SConsul/SoundLocalizer/Simulation/Comparator.PNG

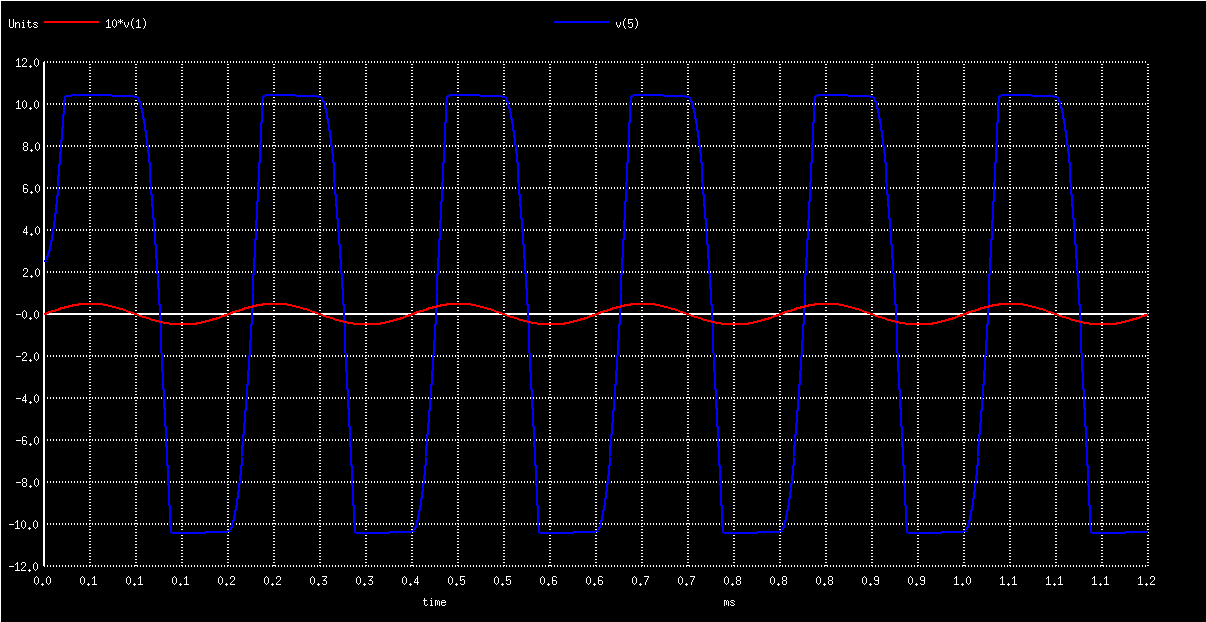
Simulation/Comparator.PNG
