SConsul/SoundLocalizer/Simulation/DelayCir/VT=0.PNG

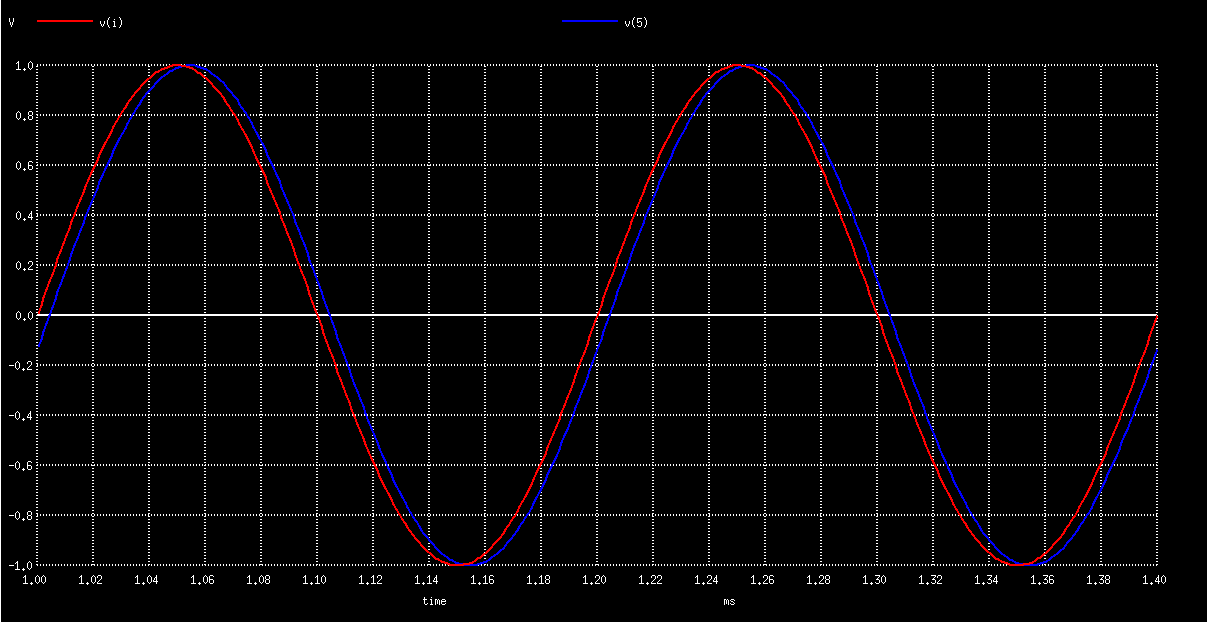
Simulation/DelayCir/VT=0.PNG
