SConsul/SoundLocalizer/Simulation/DelayCir/VT=-3.PNG

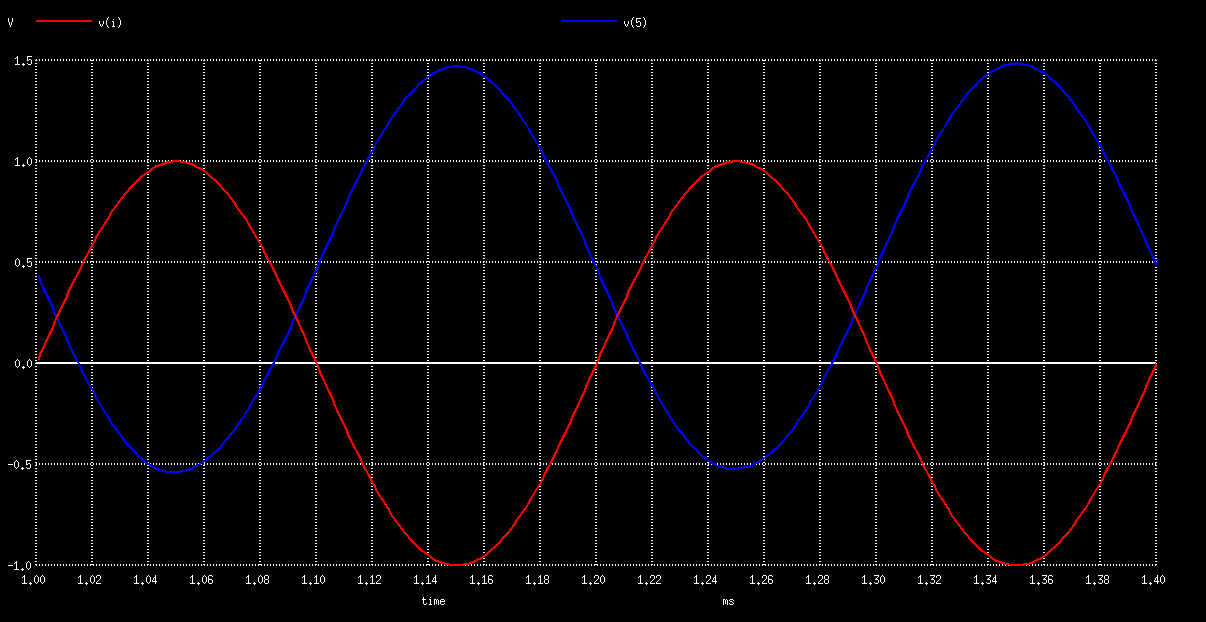
Simulation/DelayCir/VT=-3.PNG
