SConsul/SoundLocalizer/Simulation/DelayCircuit/0.4V.PNG

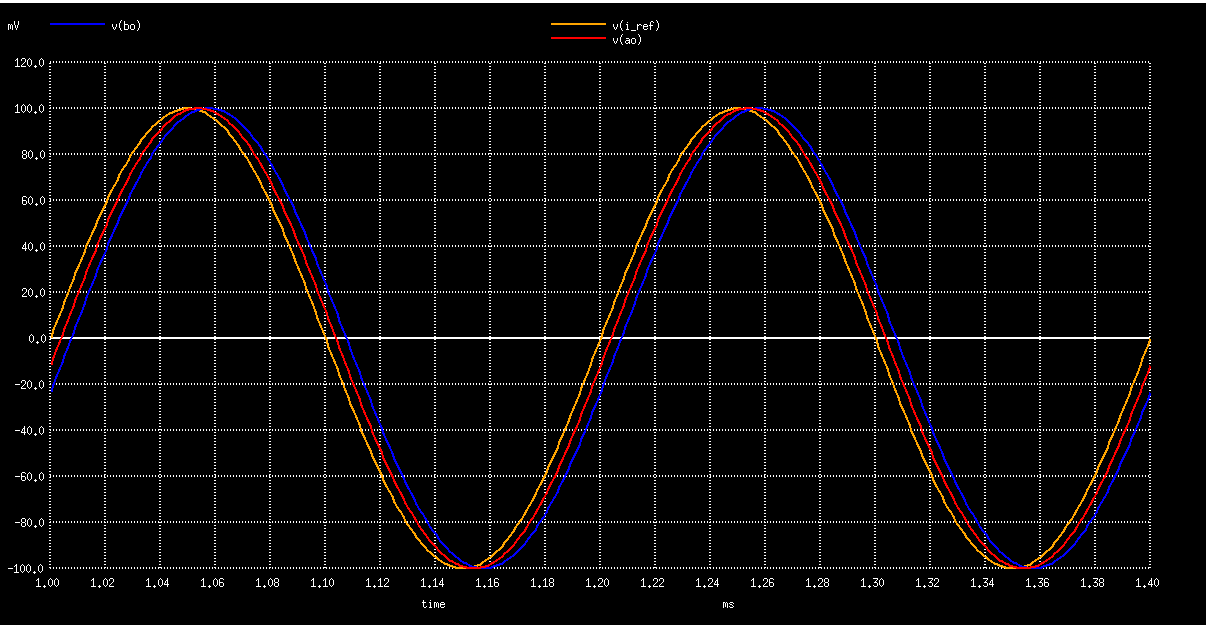
Simulation/DelayCircuit/0.4V.PNG
