SConsul/SoundLocalizer/Simulation/DelayCircuit/-0.8V.PNG

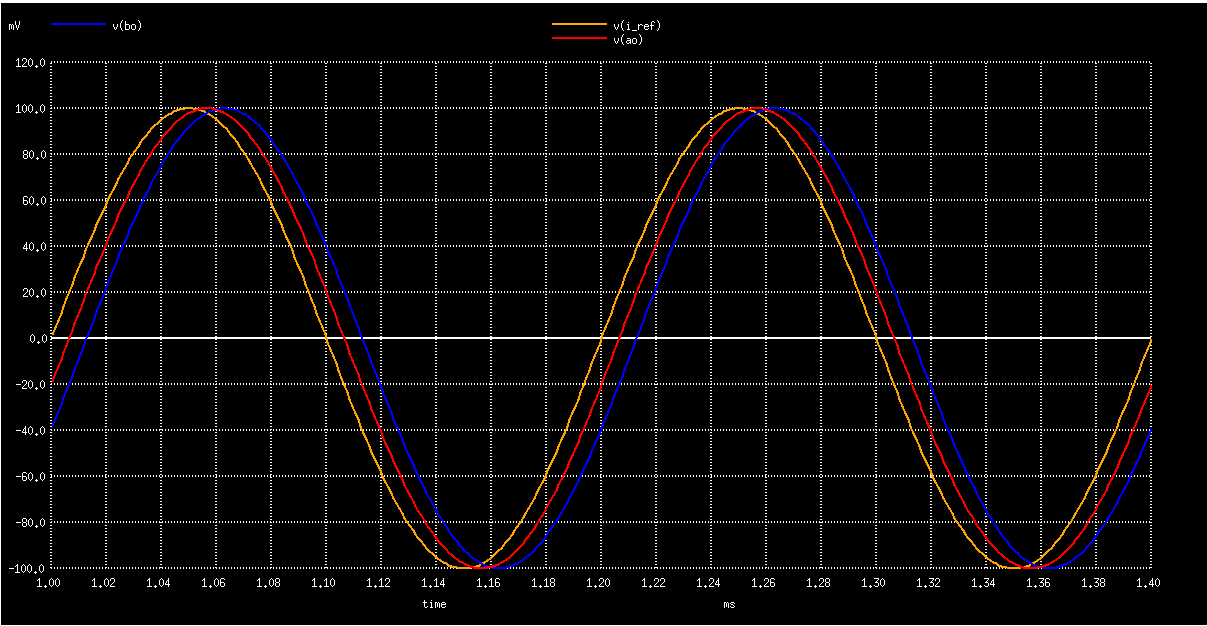
Simulation/DelayCircuit/-0.8V.PNG
