SConsul/SoundLocalizer/Simulation/DelayCircuit/-1.6V.PNG

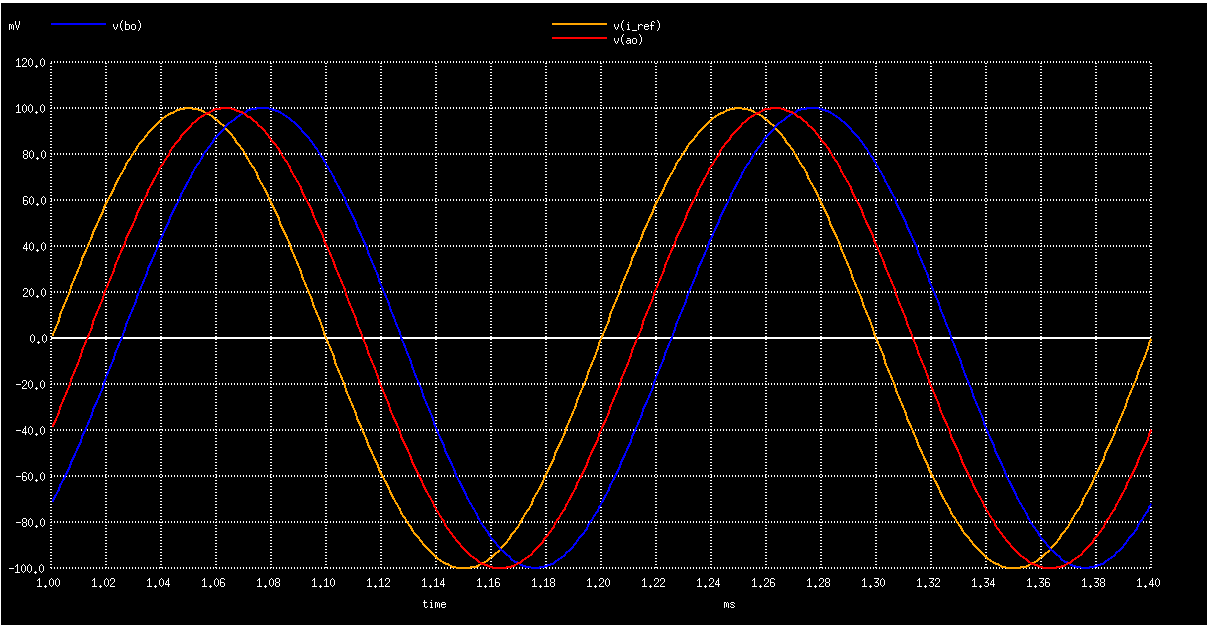
Simulation/DelayCircuit/-1.6V.PNG
