SConsul/SoundLocalizer/Simulation/Integrator/int_Square.PNG

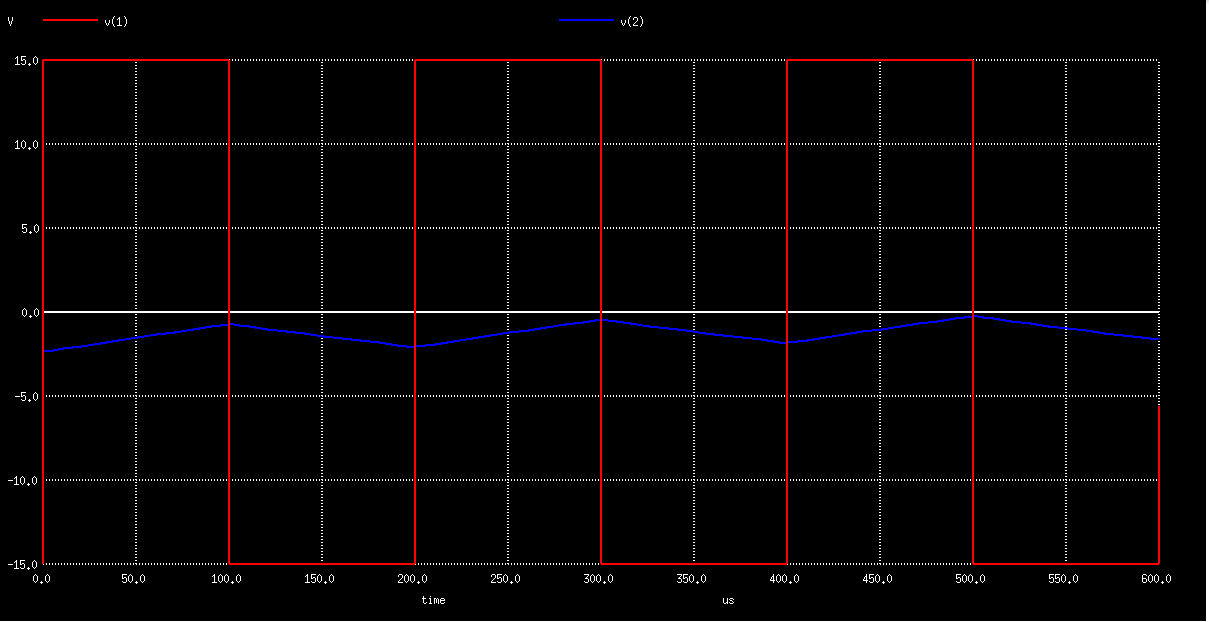
Simulation/Integrator/int_Square.PNG
