SConsul/SoundLocalizer/Simulation/JFET_IV/Id_vs_Vgs.PNG

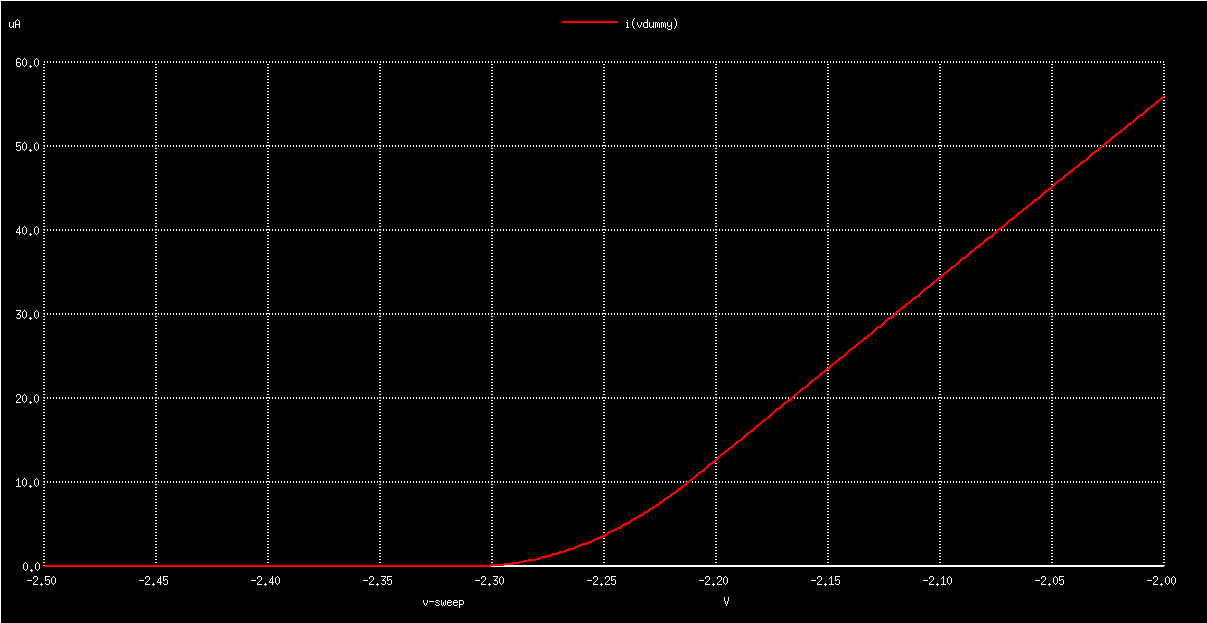
Simulation/JFET_IV/Id_vs_Vgs.PNG
