SConsul/SoundLocalizer/Simulation/JFET_IV/IV.PNG

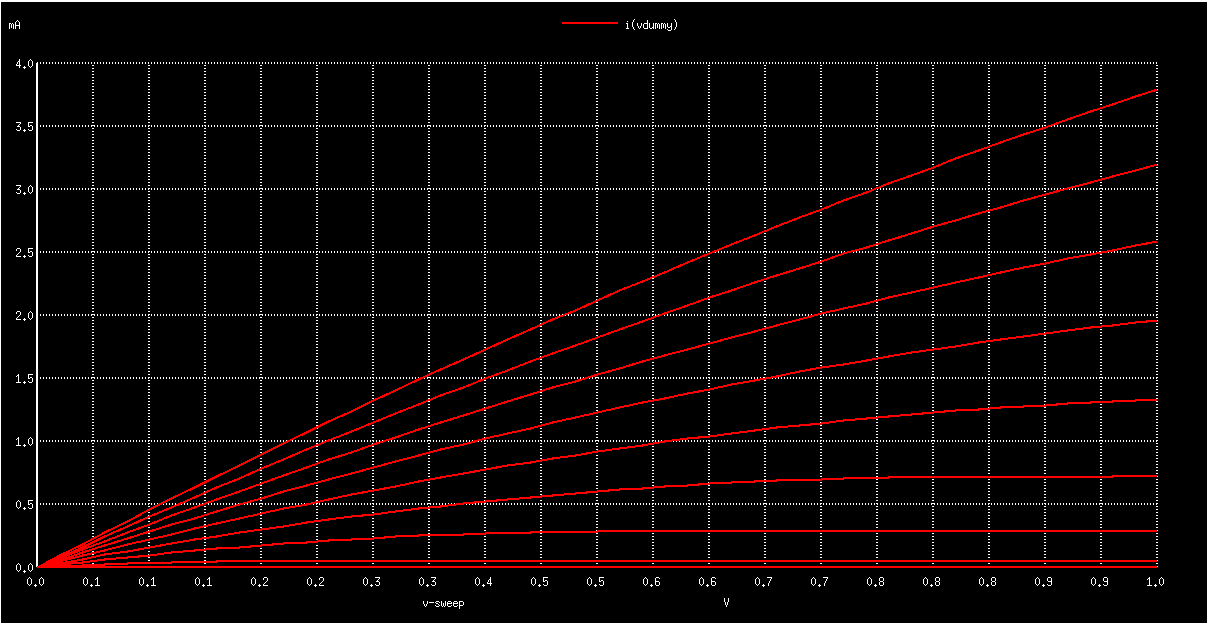
Simulation/JFET_IV/IV.PNG
