SConsul/SoundLocalizer/Simulation/DelayCircuit/delay_vs_VT.xlsx

Sheet: Sheet1
VT_DC | ref (ms) | Ao (ms) | Bo (ms) | phi1 | phi2
0.4 | 1.10002 | 1.10383 | 1.10763 | -6.858 | -13.698
0.2 | 1.1 | 1.10408 | 1.10842 | -7.344 | -15.156
0 | 1.09964 | 1.1036 | 1.10873 | -7.128 | -16.362
-0.2 | 1.1 | 1.10472 | 1.10972 | -8.496 | -17.496
-0.4 | 1.1 | 1.10582 | 1.11091 | -10.476 | -19.638
-0.6 | 1.09964 | 1.10618 | 1.1112 | -11.772 | -20.808
-0.8 | 1.10036 | 1.10691 | 1.11345 | -11.79 | -23.562
-1 | 1.1 | 1.108 | 1.11564 | -14.4 | -28.152
-1.2 | 1.10036 | 1.10909 | 1.11818 | -15.714 | -32.076
-1.4 | 1.09964 | 1.11091 | 1.12182 | -20.286 | -39.924
-1.6 | 1.1 | 1.11345 | 1.12764 | -24.21 | -49.752
-1.8 | 1.1 | 1.11855 | 1.13927 | -33.39 | -70.686
-2 | 1.10093 | 1.13056 | 1.16667 | -53.334 | -118.332
-2.2 |  |  |  | 0 | 0
 |  |  |  | 0 | 0
 |  |  |  | 0 | 0
 |  |  |  | 0 | 0
 |  |  |  | 0 | 0
 |  |  |  | 0 | 0

Sheet: Sheet2
Rds | ref (ms) | Ao (ms) | Bo (ms) | $\tau_1$ (in ms) | $\tau_2$ (in ms) | $\phi_1$ (in $\degrees$) | $\phi_2$ (in $\degrees$) | tau*c/d | Spatial Angle | phi in rad | phi' | tau' | l' |  | Rds & $\tau_2$ (in ms) & $\phi_2$ (in $\degrees$) \\
200 | 1.10036 | 1.10436 | 1.10836 | 0.004 | 0.009 | -7.201 | -14.4 | 0.102 | 84.14564896 | -0.2513274123 | 14.4 | 0.008 | 0.09066666667 | 84.79803892 | 200 & 0.009 & -14.4 \\ | 14.4
400 | 1.1 | 1.108 | 1.11673 | 0.009 | 0.017 | -14.4 | -30.114 | 0.1926666667 | 78.89155112 | -0.5255884509 | 30.114 | 0.01673 | 0.1896066667 | 79.07016939 | 400 & 0.017 & -30.114 \\ | 30.114
800 | 1.1 | 1.11564 | 1.13164 | 0.016 | 0.032 | -28.152 | -56.952 | 0.3626666667 | 68.73594425 | -0.9939999156 | 56.952 | 0.03164 | 0.3585866667 | 68.98657627 | 800 & 0.032 & -56.952 \\ | 56.952
1600 | 1.10073 | 1.13018 | 1.15964 | 0.03 | 0.059 | -53.01 | -106.038 | 0.6686666667 | 48.03575928 | -1.850712232 | 106.038 | 0.05891 | 0.6676466667 | 48.11430779 | 1600 & 0.059 & -106.038 \\ | 106.038
2000 | 1.1 | 1.136 | 1.172 | 0.036 | 0.072 | -64.8 | -129.6 | 0.816 | 35.31364005 | -2.261946711 | 129.6 | 0.072 | 0.816 | 35.31364005 | 2000 & 0.072 & -129.6 \\ | 129.6
2500 | 1.1 | 1.14255 | 1.18545 | 0.043 | 0.086 | -76.59 | -153.81 | 0.9746666667 | 12.92423753 | -2.684490922 | 153.81 | 0.08545 | 0.9684333333 | 14.43447849 | 2500 & 0.086 & -153.81 \\ | 153.81
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
30000 | 1.10093 | 1.19444 | 1.28796 | 0.094 | 0.188 | -168.318 | -336.654 | 2.130666667 | #NUM! | -5.87572074 | 23.346 | 0.01297 | 0.1469933333 | 81.5472742 | 30000 & 0.188 & -336.654 \\ | 336.654

Sheet: Sheet3
VT | ref (us) | Bo (us) | $\tau_2$ (in us) | $\phi_2$ (in $\degrees$)
0 | 208.333 | 208.796 | 0.463 | -0.834
-2 | 200.435 | 214.783 | 14.348 | -25.827
-3 | 200.43 | 220.435 | 20.005 | -36.009
