SConsul/SoundLocalizer/Simulation/SPICE/JFET_IV.cir

Family of Curves

.include bfw10.txt

*Usually, the order of terminals are
*drain, gate, source and body respectively

j1 d g gnd bfw10
vgs g gnd dc 1.8V
vds dummy gnd dc 1V
vdummy dummy d dc 0V
.control
dc vds 0 1.8 0.02 vgs -2.8 0 .1
plot i(vdummy)
.endc
.end

** at vgs swing from -2.8 to 0 Rds varies from 15k to 195
