SConsul/SoundLocalizer/(list of files, drawings)

Other design files:
Simulation/DelayCircuit/Delay_vs_Rph.opj
Simulation/JFET_IV/Rds.opj
